madhavgupta6803/EDL_Large_Signal_FerroElectric_Capacitance/README.md

# EDL_Large_Signal_FerroElectric_Capacitance

### Link to our Notion Page
### https://www.notion.so/EDL-MON-03-2ea75040919c4b7b8f81075fa2af05f8
#### The repository contains all the PCB schematic and routing files, the code files for the ADC, DAC, UART implementation, and the CAD files.
