madhavgupta6803/EDL_Large_Signal_FerroElectric_Capacitance/Results_Integrated_Circuit_Testing_with_DAC/Case1_Specs/DAC_Output_and_ADC_Input.jpeg

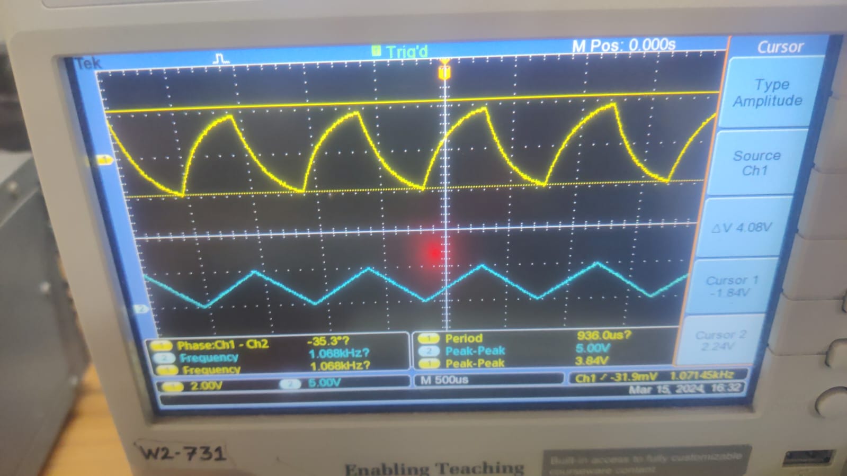
Results_Integrated_Circuit_Testing_with_DAC/Case1_Specs/DAC_Output_and_ADC_Input.jpeg
