madhavgupta6803/EDL_Large_Signal_FerroElectric_Capacitance/Final_BOM (1).xlsx

Project Title: Ferroelectric capacitance and current measurement system
Group ID: MON-03
Name of the Group Member/s: Pranav Jain, Dhrumil Lotiya, Madhav Gupta, Krisha Shah
Contact details of the Group Member responsible for BOM: +91 9302040111
BOM
Sr.No | Part description (OpAMP,ADC,DAC etc) | Manufacturing Part Number | Vendor | Link | Required Qty+Spare | Cost per each item | Total Cost
1 | OpAMP | LM324 | WEL Lab | - | 1+3 | - | -
2 | Diode | AD1580 | element14 | https://in.element14.com/analog-devices/ad1580brtz-r2/volt-ref-1-2v-sot-23-40-to-85deg/dp/4030866 | 1+3 | 292.99 | 1171.96
3 | Diode | LM4040/2.5V | Digikey | http://digikey.in/en/products/detail/stmicroelectronics/LM4040CECT-2-5/16184093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 | 1+3 | 78.98 | 315.92
4 | Diode | 1N4736A | element14 | https://in.element14.com/onsemi/1n4736a/diode-zener-6-8v-do-41/dp/1467574?st=1n4736a | 2+4 | 23.25 | 139.5
5 | Analog Potentiometer | 3296W-1-103RLF | element14 | http://in.element14.com/bourns/3296w-1-103rlf/pot-trimmer-10kohm-25turn-panel/dp/3801624 | 2+2 | 192.63 | 770.5
6 | Analog Potentiometer | 3296Z-1-105LF | element14 | http://in.element14.com/bourns/3296z-1-105lf/trimmer-pot-1mohm-10-25turn-th/dp/2328429 | 1+1 | 207.89 | 415.78
7 | Analog Potentiometer | 3296W-1-501LF | element14 | https://in.element14.com/bourns/3296w-1-501lf/trimmer-25-turn-500r/dp/9353283 | 1+1 | 203.59 | 407.18
8 | Analog Potentiometer | 3296X-1-203LF | element14 | http://in.element14.com/bourns/3296x-1-203lf/trimmer-25-turn-20k/dp/9353429 | 1+1 | 201.05 | 402.1
9 | Microcontroller | STM32F103VCT6TR | WEL Lab | - | 1+2 | - | -
10 | DAC | MCP4921 | WEL Lab | - | 1+2 | - | -
11 | Resistor | 3k (through hole) | WEL Lab | - | 1+3 | - | -
12 | Resistor | 4.7k (through hole) | WEL Lab | - | 2+6 | - | -
13 | Resistor | 10k (through hole) | WEL Lab | - | 1+3 | - | -
14 | Resistor | 20k (through hole) | WEL Lab | - | 1+3 | - | -
15 | Resistor | 27k (through hole) | WEL Lab | - | 1+3 | - | -
16 | Resistor | 82k (through hole) | WEL Lab | - | 1+3 | - | -
17 | Resistor | 100k (through hole) | WEL Lab | - | 1+3 | - | -
18 | Ref Capacitor | C0805C620J5GACTU (62pF) | element14 | https://in.element14.com/kemet/c0805c620j5gactu/cap-62pf-50v-5-c0g-np0-0805/dp/2819789 | 1+9 | 7.55 | 75.5
19 | Ref Capacitor | C0805C110J5GACTU (11pF) | element14 | https://in.element14.com/kemet/c0805c110j5gactu/cap-11pf-50v-5-c0g-np0-0805/dp/2905207 | 1+9 | 12.29 | 122.9
20 | Ref Capacitor | C0805C360J5GACTU (36pF) | element14 | https://in.element14.com/kemet/c0805c360j5gactu/cap-36pf-50v-5-c0g-np0-0805/dp/2773255 | 1+9 | 8.68 | 86.8
21 | Testing Capacitor (THT) | 22pF | WEL Lab | - | 1+10 | - | -
22 | Testing Capacitor (THT) | 47pF | WEL Lab | - | 1+10 | - | -
23 | Testing Capacitor (THT) | 82pF | WEL Lab | - | 1+10 | - | -
24 | Testing Capacitor (THT) | 1pF | WEL Lab | - | 1+10 | - | -
25 | PICOIRIS | - | WEL Lab | - | 1 | - | -
26 | SMPS | - | WEL Lab | - | 1 | - | -
27 | DC-DC Converter | MC34063ADG | WEL Lab | - | 1+3 | - | -
28 | IC Socket 8 Pin | - | WEL Lab | - | 1+3 | - | -
29 | IC Socket 14 Pin | - | WEL Lab | - | 1+3 | - | -
30 | UART Module | - | WEL Lab | - | 1 | - | -
31 | ADC | AD7276AUJZ-500RL7 | element14 | https://in.element14.com/analog-devices/ad7276aujz-500rl7/adc-12bit-3msps-tsot-6/dp/4016455RL | 1+1 | 476.42 | 952.84
 |  |  |  |  |  | Final Cost | 4860.98
