madhavgupta6803/EDL_Large_Signal_FerroElectric_Capacitance/(list of files, cad)

Other CAD files:
PCB Box.f3d
