madhavgupta6803/EDL_Large_Signal_FerroElectric_Capacitance/sim_iter_1.asc

C1: cap; 100p
C2: cap; 100p
D1: diode
D2: diode
R1: res; 20K
R2: res; 10K
R3: res; 4.7K
R4: res; 2K
R5: res; 5K
R6: res; 1000K
R7: res; 1k
R8: res; 4k
R9: res; 1k
R10: res; 1k
R11: res; 120k
R12: res; 100k
R13: res; 3.5k
R14: res; 27k
R15: res; 1k
U1: UniversalOpAmp1
U2: UniversalOpAmp1
U3: UniversalOpAmp
U4: UniversalOpAmp1
U5: LT1004-2.5
U6: LT1004-2.5
V1: voltage; 1.225
V2: voltage; +12
V3: voltage; +12
V4: voltage; +5
V5: voltage; 5
V9: voltage; PULSE(0 5 0 0.05m 0.05m 0 0 500)
V10: voltage; +12
V11: voltage; +12
Named nets: 0, OUT
.tran 0 50m 1m
.tran 0 10m 0
