madhavgupta6803/EDL_Large_Signal_FerroElectric_Capacitance/PCB_iter_3.brd

## EAGLE design PCB_iter_3.brd (2024-03-29)

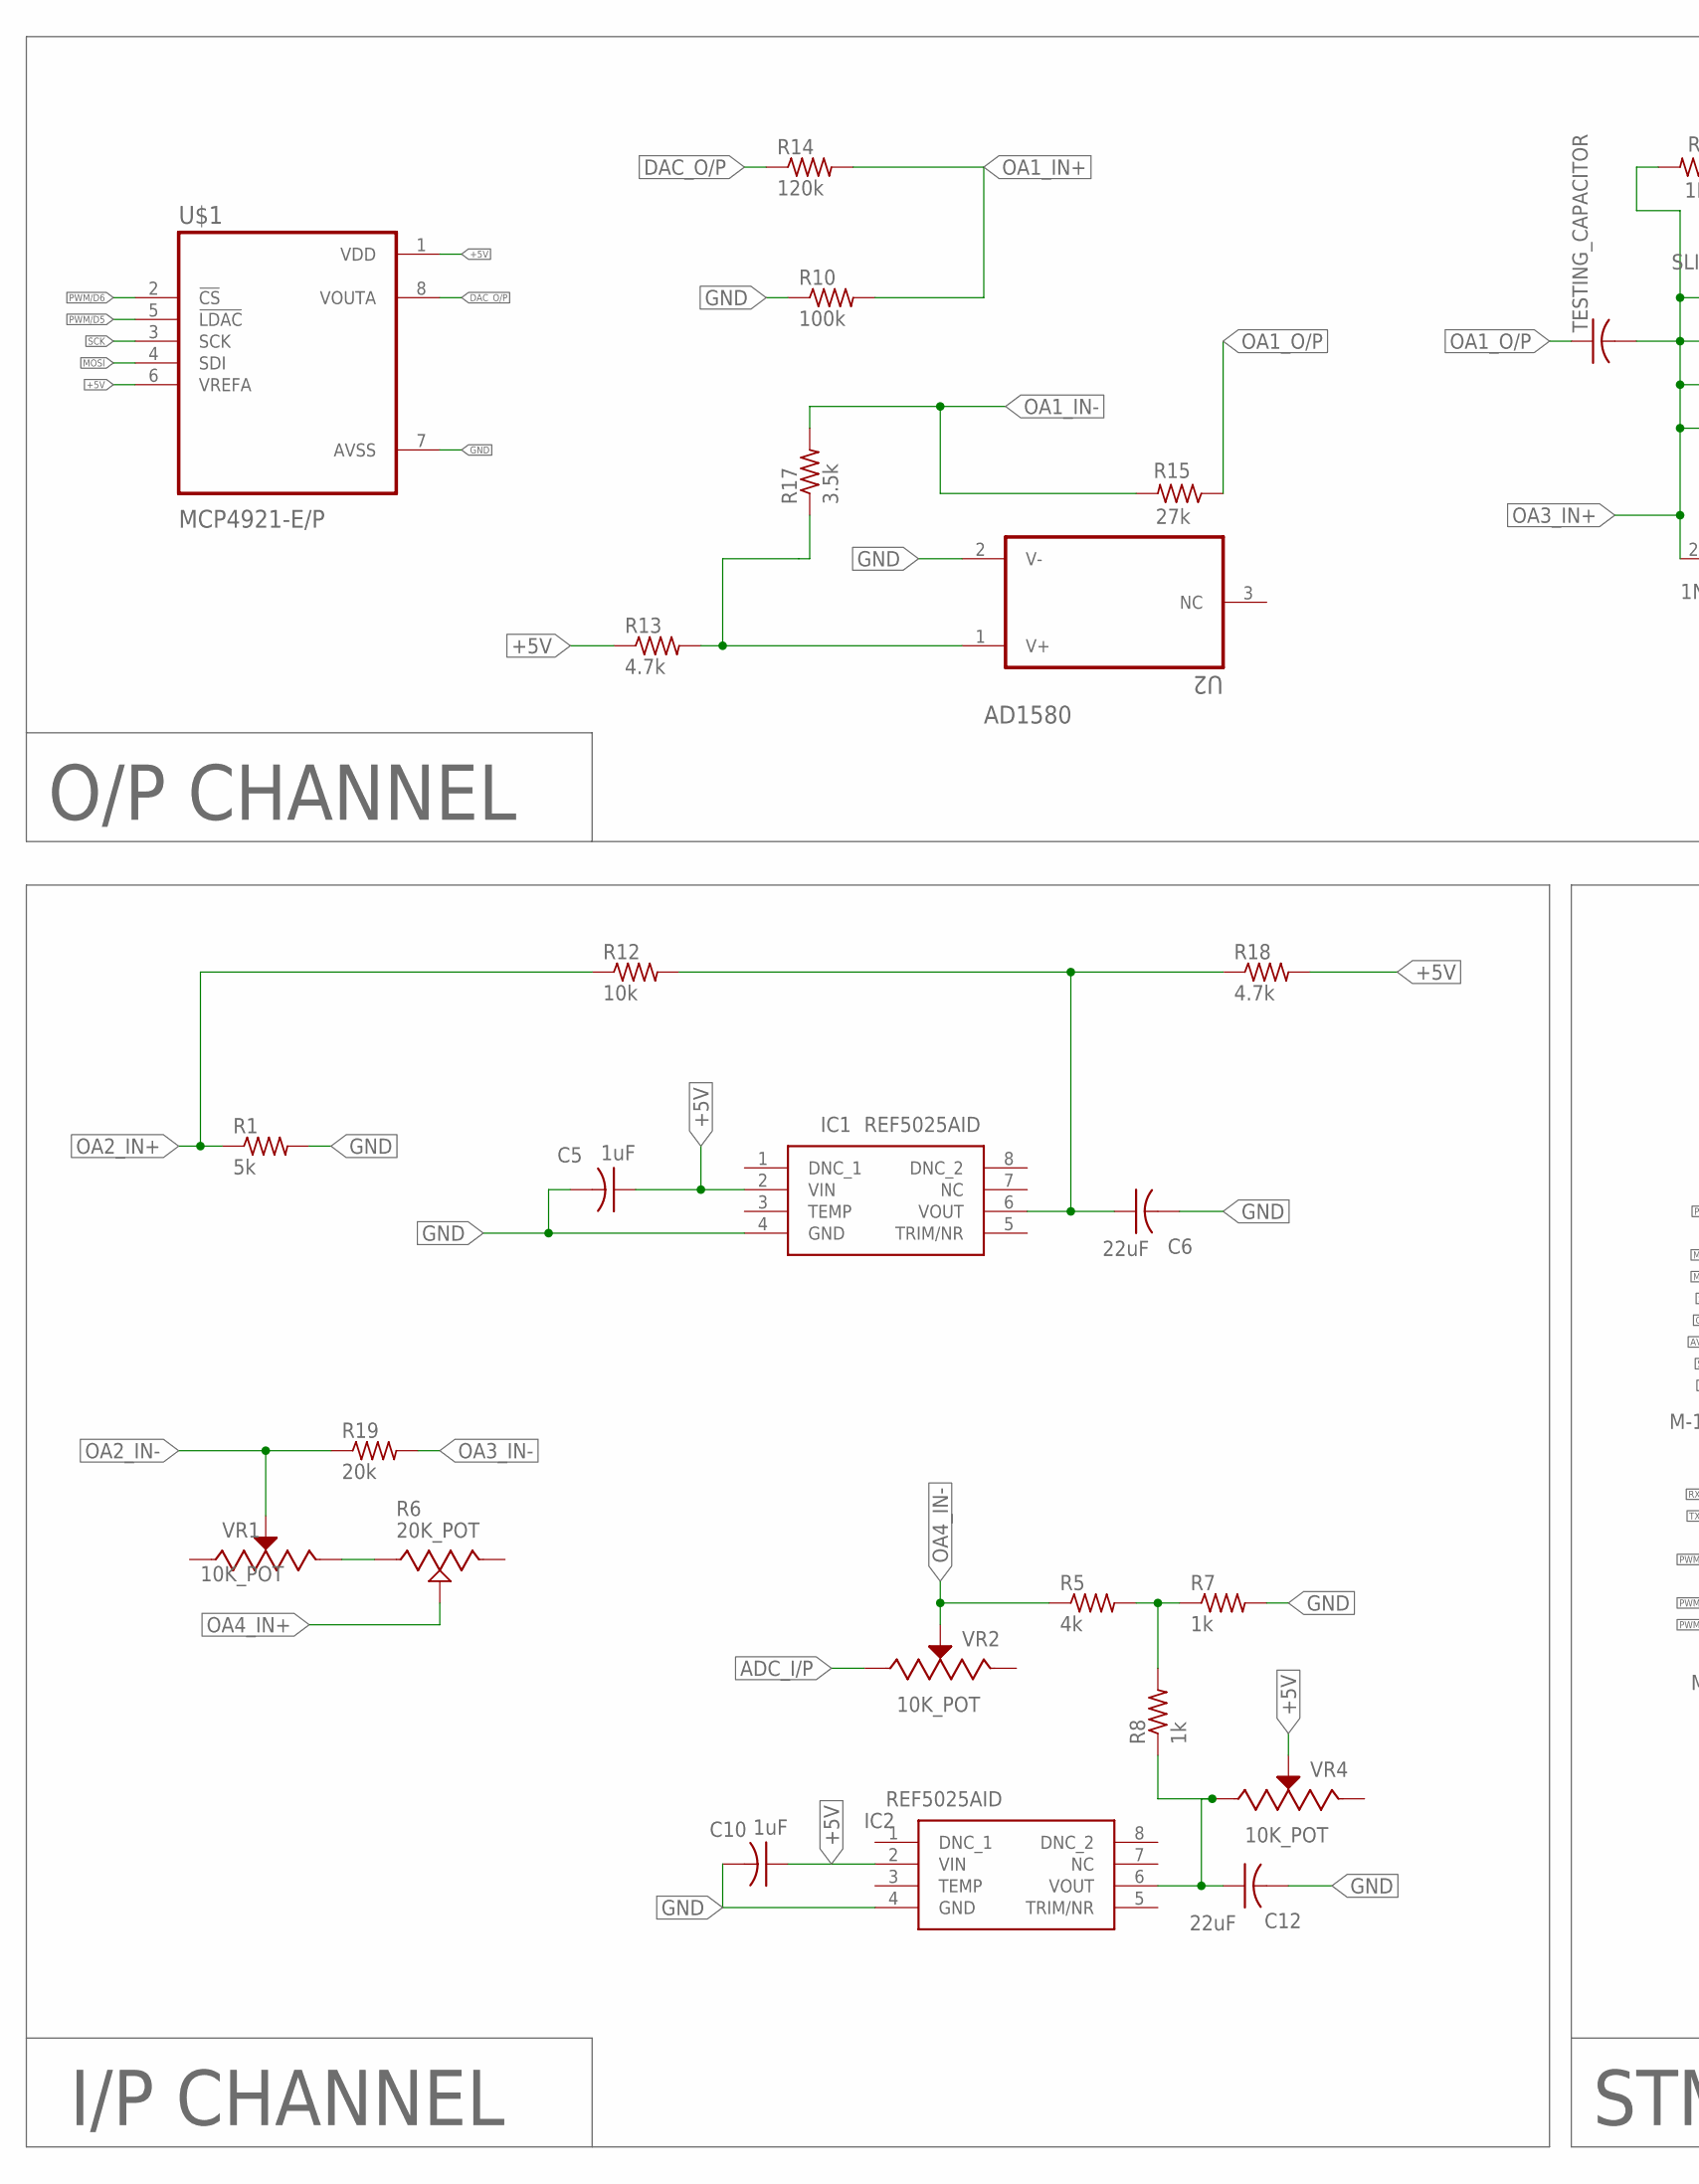
[picture p14: schematic PCB_iter_3.sch, part in row 1, column 1]

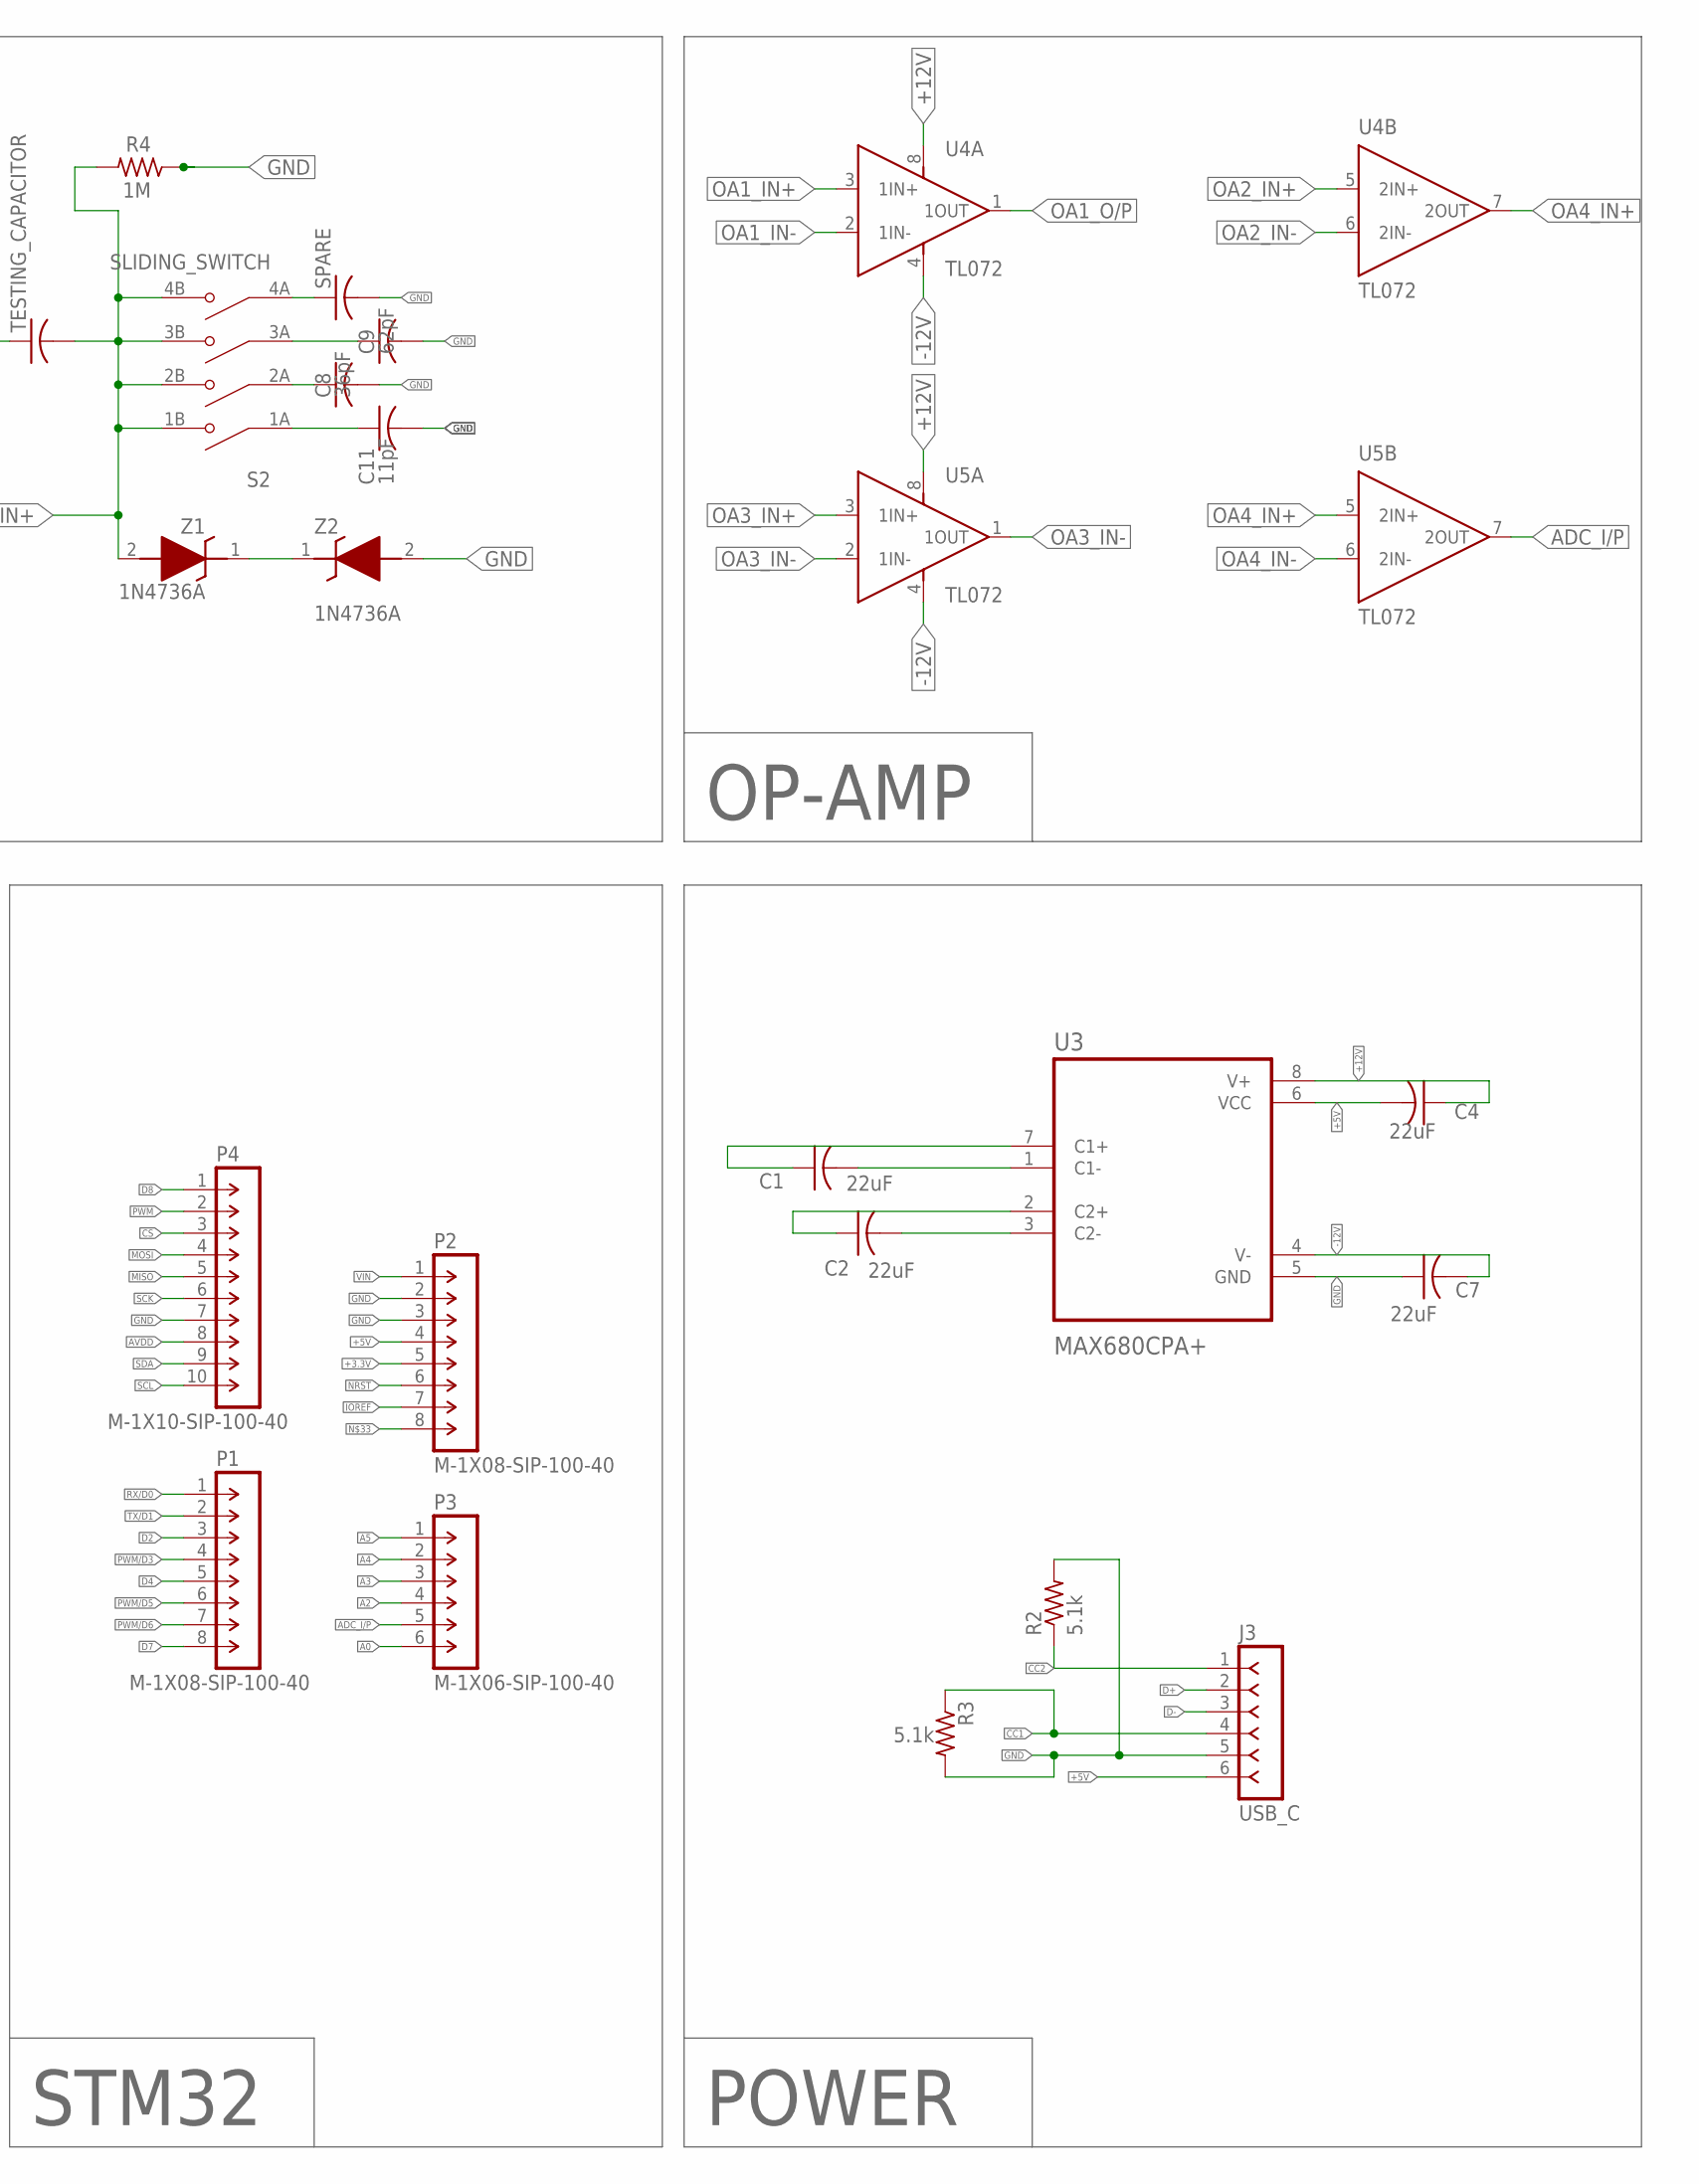
[picture p15: schematic PCB_iter_3.sch, part in row 1, column 2]

Parts:
C1, C2, C4, C6, C7, C12: 22uF; C1206
C5, C10: 1uF; C1206
C8: 36pF; C1206
C9: 62pF; C1206
C11: 11pF; C1206
IC1, IC2: REF5025AID; SOIC127P600X175-8N
J3: USB_C; SIP-100-06-40Y
P1, P2: M-1X08-SIP-100-40; SIP-100-08-40
P3: M-1X06-SIP-100-40; SIP-100-06-40
P4: M-1X10-SIP-100-40; SIP-100-10-40
R1: 5k; M1206
R2, R3: 5.1k; R1206
R4: 1M; M1206
R5: 4k; M1206
R6: 20K_POT; TRIM_3296X-1-203LF
R7, R8: 1k; M1206
R10: 100k; M1206
R12: 10k; M1206
R13, R18: 4.7k; M1206
R14: 120k; M1206
R15: 27k; M1206
R17: 3.5k; M1206
R19: 20k; M1206
S2: SLIDING_SWITCH; SW_DS01C-254-S-04BE
SPARE: C-USC1206; C1206
TESTING_CAPACITOR: C-US050-030X075; C050-030X075
U2: AD1580; SOT96P237X112-3N
U3: MAX680CPA+; DIP794W47P254L991H457Q8
U4, U5: TL072; DIP794W45P254L1060H508Q8
U$1: MCP4921-E/P; DIP787W46P254L927H533Q8
VR1, VR2, VR4: 10K_POT; TRIM_3296W-1-103RLF
Z1, Z2: 1N4736A; DIOAD1413W86L463D238

Connections:
+3.3V: P2.5
+5V: C4.2, C5.1, C10.1, IC1.2 (VIN), IC2.2 (VIN), J3.6, P2.4, R13.1, R18.2, U3.6 (VCC), U$1.1 (VDD), U$1.6 (VREFA), VR4.2 (WIPER)
+12V: C4.1, U3.8 (V+), U4.8 (VCC+), U5.8 (VCC+)
-12V: C7.2, U3.4 (V-), U4.4 (VCC-), U5.4 (VCC-)
A0: P3.6
A2: P3.4
A3: P3.3
A4: P3.2
A5: P3.1
ADC_I/P: P3.5, U5.7 (2OUT), VR2.1 (CCW)
AVDD: P4.8
CC1: J3.4, R3.1
CC2: J3.1, R2.1
CS: P4.3
D2: P1.3
D4: P1.5
D7: P1.8
D8: P4.1
D+: J3.2
D-: J3.3
DAC_O/P: R14.1, U$1.8 (VOUTA)
GND: C5.2, C6.2, C7.1, C8.2, C9.2, C10.2, C11.2, C12.2, IC1.4 (GND), IC2.4 (GND), J3.5, P2.2, P2.3, P4.7, R1.2, R2.2, R3.2, R4.1, R7.2, R10.1, SPARE.2, U2.2 (V-), U3.5 (GND), U$1.7 (AVSS), Z2.2 (A)
IOREF: P2.7
MISO: P4.5
MOSI: P4.4, U$1.4 (SDI)
unnamed: R6.1 (CCW), VR1.3 (CW)
unnamed: R5.2, R7.1, R8.2
unnamed: C12.1, IC2.6 (VOUT), R8.1, VR4.1 (CCW)
unnamed: C1.2, U3.1 (C1-)
unnamed: R13.2, R17.1, U2.1 (V+)
unnamed: C6.1, IC1.6 (VOUT), R12.2, R18.1
unnamed: Z1.1 (K), Z2.1 (K)
unnamed: C1.1, U3.7 (C1+)
unnamed: C2.2, U3.3 (C2-)
unnamed: C2.1, U3.2 (C2+)
unnamed: C9.1, S2.3A (COM3)
unnamed: S2.4A (COM4), SPARE.1
unnamed: C11.1, S2.1A (COM1)
unnamed: C8.1, S2.2A (COM2)
NRST: P2.6
OA1_IN+: R10.2, R14.2, U4.3 (1IN+)
OA1_IN-: R15.2, R17.2, U4.2 (1IN-)
OA1_O/P: R15.1, TESTING_CAPACITOR.1, U4.1 (1OUT)
OA2_IN+: R1.1, R12.1, U4.5 (2IN+)
OA2_IN-: R19.1, U4.6 (2IN-), VR1.2 (WIPER)
OA3_IN+: R4.2, S2.1B (NO1), S2.2B (NO2), S2.3B (NO3), S2.4B (NO4), TESTING_CAPACITOR.2, U5.3 (1IN+), Z1.2 (A)
OA3_IN-: R19.2, U5.1 (1OUT), U5.2 (1IN-)
OA4_IN+: R6.2 (WIPER), U4.7 (2OUT), U5.5 (2IN+)
OA4_IN-: R5.1, U5.6 (2IN-), VR2.2 (WIPER)
PWM: P4.2
PWM/D3: P1.4
PWM/D5: P1.6, U$1.5 (!LDAC)
PWM/D6: P1.7, U$1.2 (!CS)
RX/D0: P1.1
SCK: P4.6, U$1.3 (SCK)
SCL: P4.10
SDA: P4.9
TX/D1: P1.2
VIN: P2.1

Notes on the sheet:
POWER
STM32
I/P CHANNEL
OP-AMP
O/P CHANNEL

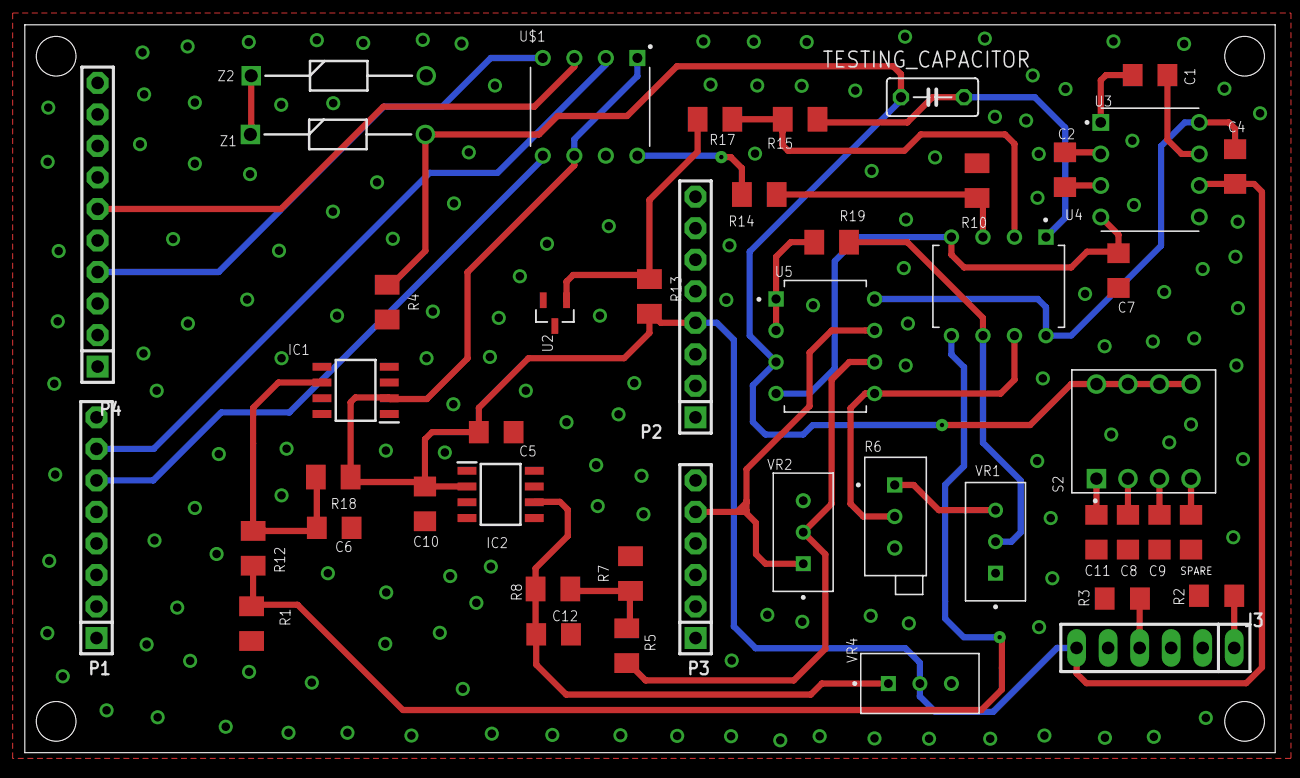
[picture p16: board PCB_iter_3.brd from above]

Board: 2 copper layers, 100.7 x 58.6 mm, 47 parts (0 on the bottom side), 35 nets.
