madhavgupta6803/EDL_Large_Signal_FerroElectric_Capacitance/Code_with_Terminal_Automation/Core/Src/main.c

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
/* Includes ------------------------------------------------------------------*/
#include "main.h"
#include <stdio.h>
#include <string.h>
ADC_HandleTypeDef hadc1;

SPI_HandleTypeDef hspi1;

UART_HandleTypeDef huart2;

void SystemClock_Config(void);
static void MX_GPIO_Init(void);
static void MX_ADC1_Init(void);
static void MX_SPI1_Init(void);
static void MX_USART2_UART_Init(void);
/* USER CODE BEGIN 0 */

void UART_SendString(const char *str) {
    while (*str) {
        while (!(USART2->SR & USART_SR_TXE));
        USART2->DR = *str++;
    }
}

void generate_wave_case1(void) {
	uint8_t myData[2];
	uint16_t adc_Value = 0;
	uint16_t adc_array[80];
	char msg[16];

	// Define a global index variable to keep track of the position in the array
	uint8_t adc_index = 0;
    // Code for generating wave for case 1
	  for (uint16_t voltage = 500; voltage <= 4000; voltage +=100) // Decrement voltage in steps
		 {
	   myData[0] = (voltage >> 8) | 0x30; // First byte (configuration bits + MSB)
	   myData[1] = voltage & 0xFF;        // Second byte (LSB)
	   HAL_GPIO_WritePin(GPIOB, GPIO_PIN_4, GPIO_PIN_SET);
	   HAL_GPIO_WritePin(GPIOB, GPIO_PIN_10, GPIO_PIN_RESET);
	   HAL_SPI_Transmit(&hspi1, myData, sizeof(myData), HAL_MAX_DELAY);
	   HAL_GPIO_WritePin(GPIOB, GPIO_PIN_10, GPIO_PIN_SET);
	   HAL_GPIO_WritePin(GPIOB, GPIO_PIN_4, GPIO_PIN_RESET);
	  HAL_ADC_Start(&hadc1);

	 // Wait for ADC conversion to complete
	 HAL_ADC_PollForConversion(&hadc1, HAL_MAX_DELAY);

	 // Read ADC value
	 adc_Value = HAL_ADC_GetValue(&hadc1);
	 adc_array[adc_index++] = adc_Value;
		 }
	  for (uint16_t voltage = 4000; voltage > 0; voltage -=100) // Decrement voltage in steps
		 {
	   myData[0] = (voltage >> 8) | 0x30; // First byte (configuration bits + MSB)
	   myData[1] = voltage & 0xFF;        // Second byte (LSB)
	   HAL_GPIO_WritePin(GPIOB, GPIO_PIN_4, GPIO_PIN_SET);
	   HAL_GPIO_WritePin(GPIOB, GPIO_PIN_10, GPIO_PIN_RESET);
	   HAL_SPI_Transmit(&hspi1, myData, sizeof(myData), HAL_MAX_DELAY);
	   HAL_GPIO_WritePin(GPIOB, GPIO_PIN_10, GPIO_PIN_SET);
	   HAL_GPIO_WritePin(GPIOB, GPIO_PIN_4, GPIO_PIN_RESET);
	  HAL_ADC_Start(&hadc1);

	 // Wait for ADC conversion to complete
	 HAL_ADC_PollForConversion(&hadc1, HAL_MAX_DELAY);

	 // Read ADC value
	 adc_Value = HAL_ADC_GetValue(&hadc1);
	 adc_array[adc_index++] = adc_Value;
		 }
		for (int i = 0; i < sizeof(adc_array) / sizeof(adc_array[0]); i++) {
		    sprintf(msg, "%hu\r\n", adc_array[i]); // Format current ADC value
		    HAL_UART_Transmit(&huart2, (uint8_t *)msg, strlen(msg), HAL_MAX_DELAY); // Transmit formatted value via UART
		}
}

void generate_wave_case2(void) {
	uint8_t myData[2];
	uint16_t adc_Value = 0;
	uint16_t adc_array[160];
	char msg[16];
	uint8_t adc_index = 0;
    // Code for generating wave for case 2
	for (uint16_t voltage = 2100; voltage <= 4000; voltage +=100) // Increment voltage in steps
	 {
	   // Construct SPI data
	   myData[0] = (voltage >> 8) | 0x30; // First byte (configuration bits + MSB)
	   myData[1] = voltage & 0xFF;        // Second byte (LSB)

	   // Set CS pin low to select MCP4921
	   HAL_GPIO_WritePin(GPIOB, GPIO_PIN_4, GPIO_PIN_SET);
	   HAL_GPIO_WritePin(GPIOB, GPIO_PIN_10, GPIO_PIN_RESET);

	   // Transmit SPI data
	   HAL_SPI_Transmit(&hspi1, myData, sizeof(myData), HAL_MAX_DELAY);

	   // Set CS pin high to deselect MCP4921
	   HAL_GPIO_WritePin(GPIOB, GPIO_PIN_10, GPIO_PIN_SET);
	   HAL_GPIO_WritePin(GPIOB, GPIO_PIN_4, GPIO_PIN_RESET);
	  HAL_ADC_Start(&hadc1);

	 // Wait for ADC conversion to complete
	 HAL_ADC_PollForConversion(&hadc1, HAL_MAX_DELAY);

	 // Read ADC value
	 adc_Value = HAL_ADC_GetValue(&hadc1);
	 adc_array[adc_index++] = adc_Value;
	 }
	for (uint16_t voltage = 4000; voltage > 2000; voltage -=100) // Increment voltage in steps
	 {
	   // Construct SPI data
	   myData[0] = (voltage >> 8) | 0x30; // First byte (configuration bits + MSB)
	   myData[1] = voltage & 0xFF;        // Second byte (LSB)

	   // Set CS pin low to select MCP4921
	   HAL_GPIO_WritePin(GPIOB, GPIO_PIN_4, GPIO_PIN_SET);
	   HAL_GPIO_WritePin(GPIOB, GPIO_PIN_10, GPIO_PIN_RESET);

	   // Transmit SPI data
	   HAL_SPI_Transmit(&hspi1, myData, sizeof(myData), HAL_MAX_DELAY);

	   // Set CS pin high to deselect MCP4921
	   HAL_GPIO_WritePin(GPIOB, GPIO_PIN_10, GPIO_PIN_SET);
	   HAL_GPIO_WritePin(GPIOB, GPIO_PIN_4, GPIO_PIN_RESET);
		  HAL_ADC_Start(&hadc1);

		 // Wait for ADC conversion to complete
		 HAL_ADC_PollForConversion(&hadc1, HAL_MAX_DELAY);

		 // Read ADC value
		 adc_Value = HAL_ADC_GetValue(&hadc1);
		 adc_array[adc_index++] = adc_Value;
	 }
	for (uint16_t voltage = 2100; voltage <= 4000; voltage +=100) // Increment voltage in steps
	 {
	   // Construct SPI data
	   myData[0] = (voltage >> 8) | 0x30; // First byte (configuration bits + MSB)
	   myData[1] = voltage & 0xFF;        // Second byte (LSB)

	   // Set CS pin low to select MCP4921
	   HAL_GPIO_WritePin(GPIOB, GPIO_PIN_4, GPIO_PIN_SET);
	   HAL_GPIO_WritePin(GPIOB, GPIO_PIN_10, GPIO_PIN_RESET);

	   // Transmit SPI data
	   HAL_SPI_Transmit(&hspi1, myData, sizeof(myData), HAL_MAX_DELAY);

	   // Set CS pin high to deselect MCP4921
	   HAL_GPIO_WritePin(GPIOB, GPIO_PIN_10, GPIO_PIN_SET);
	   HAL_GPIO_WritePin(GPIOB, GPIO_PIN_4, GPIO_PIN_RESET);
		  HAL_ADC_Start(&hadc1);

		 // Wait for ADC conversion to complete
		 HAL_ADC_PollForConversion(&hadc1, HAL_MAX_DELAY);

		 // Read ADC value
		 adc_Value = HAL_ADC_GetValue(&hadc1);
		 adc_array[adc_index++] = adc_Value;
	 }
	for (uint16_t voltage = 4000; voltage > 2000; voltage -=100) // Increment voltage in steps
	 {
	   // Construct SPI data
	   myData[0] = (voltage >> 8) | 0x30; // First byte (configuration bits + MSB)
	   myData[1] = voltage & 0xFF;        // Second byte (LSB)

	   // Set CS pin low to select MCP4921
	   HAL_GPIO_WritePin(GPIOB, GPIO_PIN_4, GPIO_PIN_SET);
	   HAL_GPIO_WritePin(GPIOB, GPIO_PIN_10, GPIO_PIN_RESET);

	   // Transmit SPI data
	   HAL_SPI_Transmit(&hspi1, myData, sizeof(myData), HAL_MAX_DELAY);

	   // Set CS pin high to deselect MCP4921
	   HAL_GPIO_WritePin(GPIOB, GPIO_PIN_10, GPIO_PIN_SET);
	   HAL_GPIO_WritePin(GPIOB, GPIO_PIN_4, GPIO_PIN_RESET);
		  HAL_ADC_Start(&hadc1);

		 // Wait for ADC conversion to complete
		 HAL_ADC_PollForConversion(&hadc1, HAL_MAX_DELAY);

		 // Read ADC value
		 adc_Value = HAL_ADC_GetValue(&hadc1);
		 adc_array[adc_index++] = adc_Value;
	 }
	for (uint16_t voltage = 2000; voltage > 0; voltage -=100) // Increment voltage in steps
	 {
	   // Construct SPI data
	   myData[0] = (voltage >> 8) | 0x30; // First byte (configuration bits + MSB)
	   myData[1] = voltage & 0xFF;        // Second byte (LSB)

	   // Set CS pin low to select MCP4921
	   HAL_GPIO_WritePin(GPIOB, GPIO_PIN_4, GPIO_PIN_SET);
	   HAL_GPIO_WritePin(GPIOB, GPIO_PIN_10, GPIO_PIN_RESET);

	   // Transmit SPI data
	   HAL_SPI_Transmit(&hspi1, myData, sizeof(myData), HAL_MAX_DELAY);

	   // Set CS pin high to deselect MCP4921
	   HAL_GPIO_WritePin(GPIOB, GPIO_PIN_10, GPIO_PIN_SET);
	   HAL_GPIO_WritePin(GPIOB, GPIO_PIN_4, GPIO_PIN_RESET);
		  HAL_ADC_Start(&hadc1);

		 // Wait for ADC conversion to complete
		 HAL_ADC_PollForConversion(&hadc1, HAL_MAX_DELAY);

		 // Read ADC value
		 adc_Value = HAL_ADC_GetValue(&hadc1);
		 adc_array[adc_index++] = adc_Value;
	 }
	for (uint16_t voltage = 100; voltage <= 2000; voltage +=100) // Increment voltage in steps
	 {
	   // Construct SPI data
	   myData[0] = (voltage >> 8) | 0x30; // First byte (configuration bits + MSB)
	   myData[1] = voltage & 0xFF;        // Second byte (LSB)

	   // Set CS pin low to select MCP4921
	   HAL_GPIO_WritePin(GPIOB, GPIO_PIN_4, GPIO_PIN_SET);
	   HAL_GPIO_WritePin(GPIOB, GPIO_PIN_10, GPIO_PIN_RESET);

	   // Transmit SPI data
	   HAL_SPI_Transmit(&hspi1, myData, sizeof(myData), HAL_MAX_DELAY);

	   // Set CS pin high to deselect MCP4921
	   HAL_GPIO_WritePin(GPIOB, GPIO_PIN_10, GPIO_PIN_SET);
	   HAL_GPIO_WritePin(GPIOB, GPIO_PIN_4, GPIO_PIN_RESET);
		  HAL_ADC_Start(&hadc1);

		 // Wait for ADC conversion to complete
		 HAL_ADC_PollForConversion(&hadc1, HAL_MAX_DELAY);

		 // Read ADC value
		 adc_Value = HAL_ADC_GetValue(&hadc1);
		 adc_array[adc_index++] = adc_Value;
	 }
	for (uint16_t voltage = 2000; voltage > 0; voltage -=100) // Increment voltage in steps
	 {
	   // Construct SPI data
	   myData[0] = (voltage >> 8) | 0x30; // First byte (configuration bits + MSB)
	   myData[1] = voltage & 0xFF;        // Second byte (LSB)

	   // Set CS pin low to select MCP4921
	   HAL_GPIO_WritePin(GPIOB, GPIO_PIN_4, GPIO_PIN_SET);
	   HAL_GPIO_WritePin(GPIOB, GPIO_PIN_10, GPIO_PIN_RESET);

	   // Transmit SPI data
	   HAL_SPI_Transmit(&hspi1, myData, sizeof(myData), HAL_MAX_DELAY);

	   // Set CS pin high to deselect MCP4921
	   HAL_GPIO_WritePin(GPIOB, GPIO_PIN_10, GPIO_PIN_SET);
	   HAL_GPIO_WritePin(GPIOB, GPIO_PIN_4, GPIO_PIN_RESET);
		  HAL_ADC_Start(&hadc1);

		 // Wait for ADC conversion to complete
		 HAL_ADC_PollForConversion(&hadc1, HAL_MAX_DELAY);

		 // Read ADC value
		 adc_Value = HAL_ADC_GetValue(&hadc1);
		 adc_array[adc_index++] = adc_Value;
	 }
	for (uint16_t voltage = 100; voltage <= 2000; voltage +=100) // Increment voltage in steps
	 {
	   // Construct SPI data
	   myData[0] = (voltage >> 8) | 0x30; // First byte (configuration bits + MSB)
	   myData[1] = voltage & 0xFF;        // Second byte (LSB)

	   // Set CS pin low to select MCP4921
	   HAL_GPIO_WritePin(GPIOB, GPIO_PIN_4, GPIO_PIN_SET);
	   HAL_GPIO_WritePin(GPIOB, GPIO_PIN_10, GPIO_PIN_RESET);

	   // Transmit SPI data
	   HAL_SPI_Transmit(&hspi1, myData, sizeof(myData), HAL_MAX_DELAY);

	   // Set CS pin high to deselect MCP4921
	   HAL_GPIO_WritePin(GPIOB, GPIO_PIN_10, GPIO_PIN_SET);
	   HAL_GPIO_WritePin(GPIOB, GPIO_PIN_4, GPIO_PIN_RESET);
		  HAL_ADC_Start(&hadc1);

		 // Wait for ADC conversion to complete
		 HAL_ADC_PollForConversion(&hadc1, HAL_MAX_DELAY);

		 // Read ADC value
		 adc_Value = HAL_ADC_GetValue(&hadc1);
		 adc_array[adc_index++] = adc_Value;
	 }
	for (int i = 0; i < sizeof(adc_array) / sizeof(adc_array[0]); i++) {
	    sprintf(msg, "%hu\r\n", adc_array[i]); // Format current ADC value
	    HAL_UART_Transmit(&huart2, (uint8_t *)msg, strlen(msg), HAL_MAX_DELAY); // Transmit formatted value via UART
	}
}

void generate_wave_case3(void){
	uint8_t myData[2];
	uint16_t adc_Value = 0;
//	uint16_t adc_array[160];
//	uint8_t loopCount = 0;
//	char msg[16];
//	uint8_t adc_index = 0;
	while(1)
	{
	  for (uint16_t voltage = 500; voltage <= 4000; voltage +=500) // Decrement voltage in steps
		 {
	   myData[0] = (voltage >> 8) | 0x30; // First byte (configuration bits + MSB)
	   myData[1] = voltage & 0xFF;        // Second byte (LSB)
	   HAL_GPIO_WritePin(GPIOB, GPIO_PIN_4, GPIO_PIN_SET);
	   HAL_GPIO_WritePin(GPIOB, GPIO_PIN_10, GPIO_PIN_RESET);
	   HAL_SPI_Transmit(&hspi1, myData, sizeof(myData), HAL_MAX_DELAY);
	   HAL_GPIO_WritePin(GPIOB, GPIO_PIN_10, GPIO_PIN_SET);
	   HAL_GPIO_WritePin(GPIOB, GPIO_PIN_4, GPIO_PIN_RESET);
//		  HAL_ADC_Start(&hadc1);
//
//		 // Wait for ADC conversion to complete
//		 HAL_ADC_PollForConversion(&hadc1, HAL_MAX_DELAY);
//
//		 // Read ADC value
//		 adc_Value = HAL_ADC_GetValue(&hadc1);
//		 adc_array[adc_index++] = adc_Value;
		 }
	  for (uint16_t voltage = 4000; voltage > 0; voltage -=500) // Decrement voltage in steps
		 {
	   myData[0] = (voltage >> 8) | 0x30; // First byte (configuration bits + MSB)
	   myData[1] = voltage & 0xFF;        // Second byte (LSB)
	   HAL_GPIO_WritePin(GPIOB, GPIO_PIN_4, GPIO_PIN_SET);
	   HAL_GPIO_WritePin(GPIOB, GPIO_PIN_10, GPIO_PIN_RESET);
	   HAL_SPI_Transmit(&hspi1, myData, sizeof(myData), HAL_MAX_DELAY);
	   HAL_GPIO_WritePin(GPIOB, GPIO_PIN_10, GPIO_PIN_SET);
	   HAL_GPIO_WritePin(GPIOB, GPIO_PIN_4, GPIO_PIN_RESET);
//		  HAL_ADC_Start(&hadc1);
//
//		 // Wait for ADC conversion to complete
//		 HAL_ADC_PollForConversion(&hadc1, HAL_MAX_DELAY);
//
//		 // Read ADC value
//		 adc_Value = HAL_ADC_GetValue(&hadc1);
//		 adc_array[adc_index++] = adc_Value;
		 }
//	  loopCount++;
	}
//	for (int i = 0; i < sizeof(adc_array) / sizeof(adc_array[0]); i++) {
//	    sprintf(msg, "%hu\r\n", adc_array[i]); // Format current ADC value
//	    HAL_UART_Transmit(&huart2, (uint8_t *)msg, strlen(msg), HAL_MAX_DELAY); // Transmit formatted value via UART
//	}
}
/* USER CODE END 0 */

/**
  * @brief  The application entry point.
  * @retval int
  */
int main(void)
{
  /* MCU Configuration--------------------------------------------------------*/

  /* Reset of all peripherals, Initializes the Flash interface and the Systick. */
  HAL_Init();

  /* Configure the system clock */
  SystemClock_Config();

  /* Initialize all configured peripherals */
  MX_GPIO_Init();
  MX_ADC1_Init();
  MX_SPI1_Init();
  MX_USART2_UART_Init();
  /* Infinite loop */
  /* USER CODE BEGIN WHILE */
  while (1)
  {
    /* USER CODE END WHILE */
	  if (USART2->SR & USART_SR_RXNE) {
	              // Read the received character
			  char received_char = USART2->DR;

			  // Process the received character
			  switch (received_char) {
				  case 'A':
					  UART_SendString("Generating wave for case 1\r\n");
					  generate_wave_case1();
					  break;
				  case 'B':
					  UART_SendString("Generating wave for case 2\r\n");
					  generate_wave_case2();
					  break;
				  case 'C':
					  UART_SendString("Generating wave for case 3\r\n");
					  generate_wave_case3();
					  break;
				  default:
					  UART_SendString("Invalid command. Please enter 'A' or 'B' or 'C'\r\n");
					  break;
			  }
		  }
    /* USER CODE BEGIN 3 */
  }
  /* USER CODE END 3 */
}

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
