madhavgupta6803/EDL_Large_Signal_FerroElectric_Capacitance/Code_with_Terminal_Automation/Code_with_Terminal_Automation.ioc

Mcu.UserName=STM32F103RBTx
PA2.Signal=USART2_TX
PA3.Signal=USART2_RX
PA4.Signal=ADCx_IN4
PA5.Signal=SPI1_SCK
PA7.Signal=SPI1_MOSI
PB10.Signal=GPIO_Output
PB4.Signal=GPIO_Output
