madhavgupta6803/EDL_Large_Signal_FerroElectric_Capacitance/(commit log)

2024-03-17 Added PCB Files
    [PCB_sch.brd, PCB_sch.sch]
2024-03-17 Added CAD File
    [PCB Box.f3d]
2024-03-19 Updated Simulation
    Currently does not give the right o/p. Changed diode in the upper circuit. Giving 2.5V using a diode. Changed the resistor values of the new op-amp as well.
2024-03-24 PCB ITERATION 2
    [PCB_brd_iter2.brd, PCB_sch_iter2.sch]
2024-03-24 Uploaded the BOM
    [Final_BOM (1).xlsx]
2024-03-27 PCB ITERATION 3
    Added holes on 4 corners with updated placement and routing
    [PCB_iter_3.brd, PCB_iter_3.sch]
2024-03-29 PCB ITERATION 4
    [PCB_iter_3.brd, PCB_iter_3.sch]
2024-04-02 FPGA DAC Files Added
    [POINTS.xlsx]
