madhavgupta6803/EDL_Large_Signal_FerroElectric_Capacitance/(notices)

Notices in the files:
Code_with_Terminal_Automation/Core/Src/main.c:
Copyright (c) 2024 STMicroelectronics.
All rights reserved.
This software is licensed under terms that can be found in the LICENSE file
parts and their libraries:
con-headers-jp: Copyright (C) 2008, Bob Starr
